jfri2/RGB_LED_DRIVER/RGB_LED_DRIVER/RGB_LED_DRIVER_NOTES/Design_BOM.xlsx

 | Part | Name | Price/unit | Units needed | Total Price | Link
 | LED Strip | 5m common anode | 9.99 | 1 | 9.99 | http://www.amazon.com/XKTTSUEERCRR-Non-Waterproof-5050-Strip-Light/dp/B006LW2NJM
* | DC Power Supply |  |  | 1 | 0 | https://www.jameco.com/webapp/wcs/stores/servlet/ProductDisplay?productId=1940272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
*** | DC Power Jack | Power Jack | 1.18 | 1 | 1.18 | http://www.digikey.com/product-detail/en/PJ-102AH/CP-102AH-ND/408448
 | 5V Regulator | 7805 | 0.62 | 1 | 0.62 | http://www.digikey.com/product-detail/en/MC7805CDTG/MC7805CDTGOS-ND/1481217
1 | Input Cap | .33uF 0805 | 0.18 | 1 | 0.18 | http://www.digikey.com/product-detail/en/CL21B334KBFNNNE/1276-1123-1-ND/3889209
 | Big Input Cap | 47uF | 1.25 | 1 | 1.25 | http://www.digikey.com/product-detail/en/C3216X5R1E476M160AC/445-8047-1-ND/2792164
 | Output Cap | .1uF 0805 | 0.1 | 1 | 0.1 | http://www.digikey.com/product-detail/en/CL21F104ZBCNNNC/1276-1007-1-ND/3889093
 | Microcontroller | ATmega328p | 3.58 | 1 | 3.58 | http://www.digikey.com/product-detail/en/ATMEGA328P-AU/ATMEGA328P-AU-ND/1832260
1 | MCU Bypass Cap | .1uF 0805 | 0.1 | 2 | 0.2 | http://www.digikey.com/product-detail/en/CL21F104ZBCNNNC/1276-1007-1-ND/3889093
 | Pin Header | 36 Pin header | 1.57 | 1 | 1.57 | http://www.digikey.com/product-detail/en/PEC36SAAN/S1012E-36-ND/859153
 | Crystal | 16 MHz Quartz | 0.38 | 1 | 0.38 | http://www.digikey.com/product-detail/en/9C-16.000MBBK-T/887-2425-1-ND/4475430
 | Crystal Cap | 18pF 0805 | 0.1 | 2 | 0.2 | http://www.digikey.com/product-detail/en/CL21C180JBANNNC/1276-1107-1-ND/3889193
 | Reset/other Switch | SMD Tactile | 0.61 | 4 | 2.44 | http://www.digikey.com/product-detail/en/ADTSM61NVTR/679-2380-1-ND/2344145
2 | 10k Resistor | 10k 0805 | 0.1 | 4 | 0.4 | http://www.digikey.com/product-detail/en/ERJ-6GEYJ103V/P10KACT-ND/43118
 | Audio Jack | 3523SJCT | 1.34 | 1 | 1.34 | http://www.digikey.com/product-detail/en/SJ-3523-SMT-TR/CP-3523SJCT-ND/669704
 | Graphic Equalizer | MSGEQ-7 | 4.95 | 1 | 4.95 | https://www.sparkfun.com/products/10468
1 | Bypass Cap | .1uF 0805 | 0.1 | 2 | 0.2 | http://www.digikey.com/product-detail/en/CL21F104ZBCNNNC/1276-1007-1-ND/3889093
 | DC Block Cap | .01uF 0805 | 0.1 | 1 | 0.1 | http://www.digikey.com/product-detail/en/CL21B103KBANNNC/1276-1015-1-ND/3889101
 | RC OSC Cap | 33pF 0805 | 0.1 | 1 | 0.1 | http://www.digikey.com/product-detail/en/CL21C330JBANNNC/1276-1105-1-ND/3889191
 | RC OSC Resistor | 200k 0805 | 0.1 | 1 | 0.1 | http://www.digikey.com/product-detail/en/RC2012F204CS/1276-5412-1-ND/3968384
 | Power N-Channel FET | IRF510 | 1.21 | 3 | 3.63 | http://www.digikey.com/product-detail/en/IRF510STRRPBF/IRF510STRRPBFCT-ND/3305330
2 | Pulldown Resistor | 10k 0805 | 0.1 | 3 | 0.3 | http://www.digikey.com/product-detail/en/ERJ-6GEYJ103V/P10KACT-ND/43118
1 | Debounce Caps | .1uF 0805 | 0.1 | 7 | 0.7
 | Audio Amp | LM321 | 0.7 | 0 | 0 | http://www.digikey.com/product-detail/en/LM321MF%2FNOPB/LM321MF%2FNOPBCT-ND/638699
1 | Bypass Cap | .1uF 0805 | 0.1 | 0 | 0 | http://www.digikey.com/product-detail/en/CL21F104ZBCNNNC/1276-1007-1-ND/3889093
