jfri2/RGB_LED_DRIVER/RGB_LED_DRIVER/RGB_LED_DRIVER_HARDWARE/EagleFiles/270_rev_00_bottom.pdf

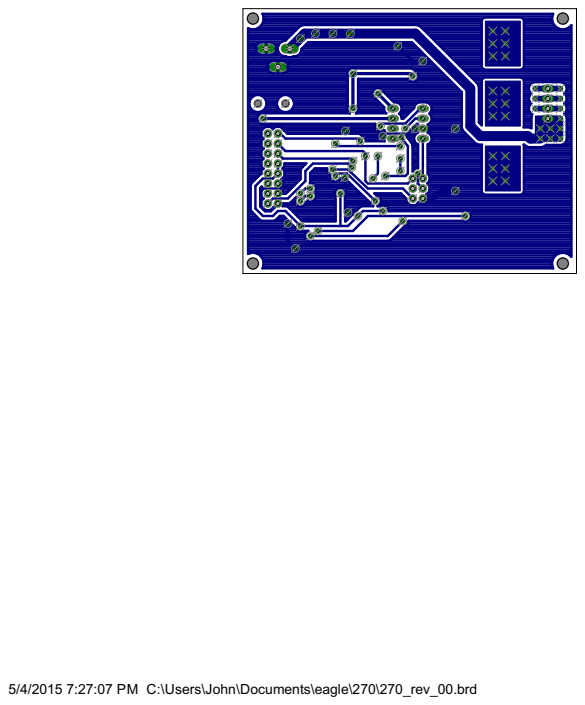
[picture p3: page 1]

5/4/2015 7:27:07 PM C:\Users\John\Documents\eagle\270\270_rev_00.brd
