jfri2/RGB_LED_DRIVER/RGB_LED_DRIVER/RGB_LED_DRIVER_HARDWARE/EagleFiles/270_rev_00_top.pdf

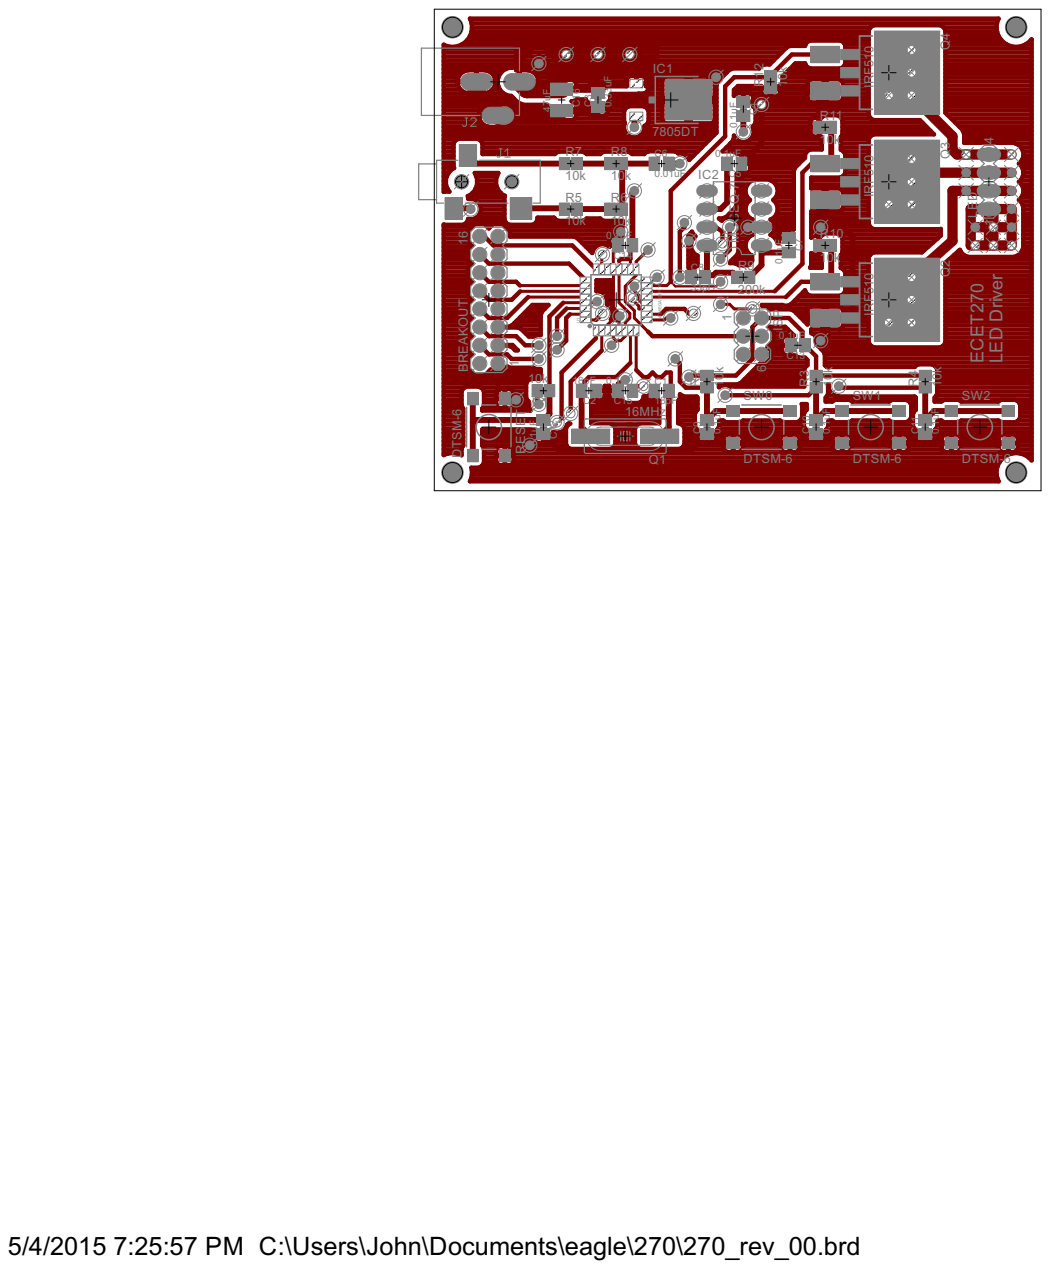
[picture p4: page 1]

16MHz

5/4/2015 7:25:57 PM C:\Users\John\Documents\eagle\270\270_rev_00.brd
