jfri2/RGB_LED_DRIVER/(commit log)

2015-06-16 Initial Commit - Software Design Concept Complete
    Functional software in semi complete state. Will add current hardware
    soon.
2015-06-16 Added in Hardware and Initial BOM
    [270_rev_00.brd, 270_rev_00.sch, Design_BOM.xlsx]
2015-06-16 Added hardware & BOM
    This has been tested and is fully functional with the custom board
    [270_rev_00.brd, 270_rev_00.sch, Design_BOM.xlsx]
