jfri2/RGB_LED_DRIVER/(notices)

Notices in the files:
parts and their libraries:
sparkfun: Licensing: Creative Commons ShareAlike 4.0 International - https://creativecommons.org/licenses/by-sa/4.0
